lamemakes/pilot-drive-HAT/hardware/3dmodels/RTC_Crystal.step

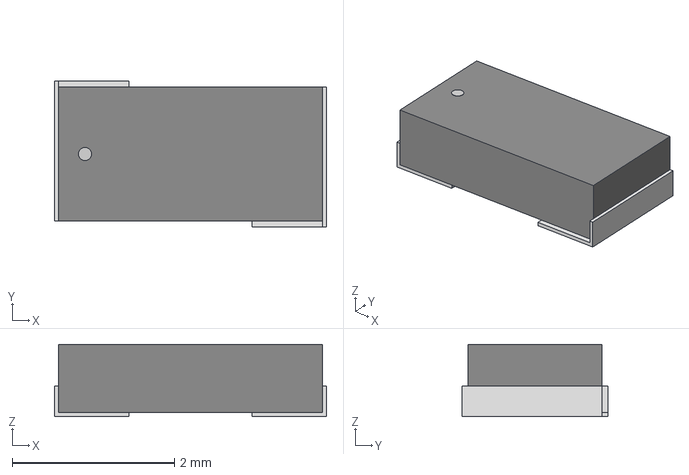
[picture p4: CAD file, 2023-02-22]
hardware/3dmodels/RTC_Crystal.step
3.35 x 1.80 x 0.892 mm
