lamemakes/pilot-drive-HAT/hardware/3dmodels/DS1307Z+T&R.step

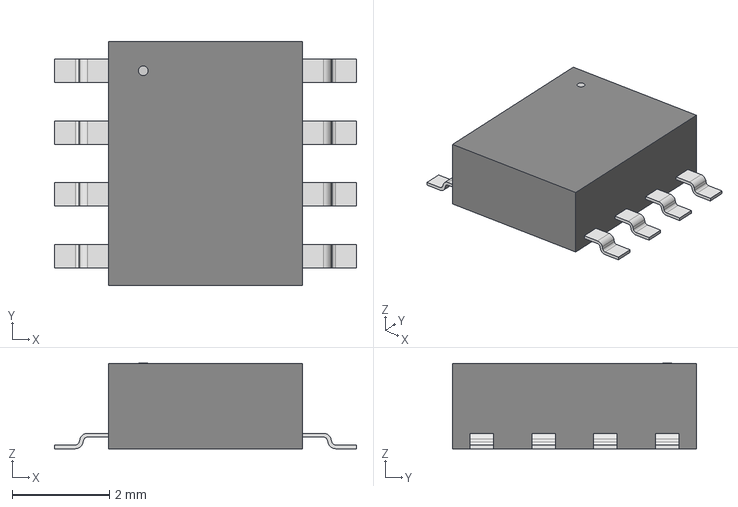
[picture p5: CAD file, 2023-02-22]
hardware/3dmodels/DS1307Z+T&R.step
6.20 x 5.00 x 1.75 mm
