lamemakes/pilot-drive-HAT/hardware/3dmodels/P_FET.step

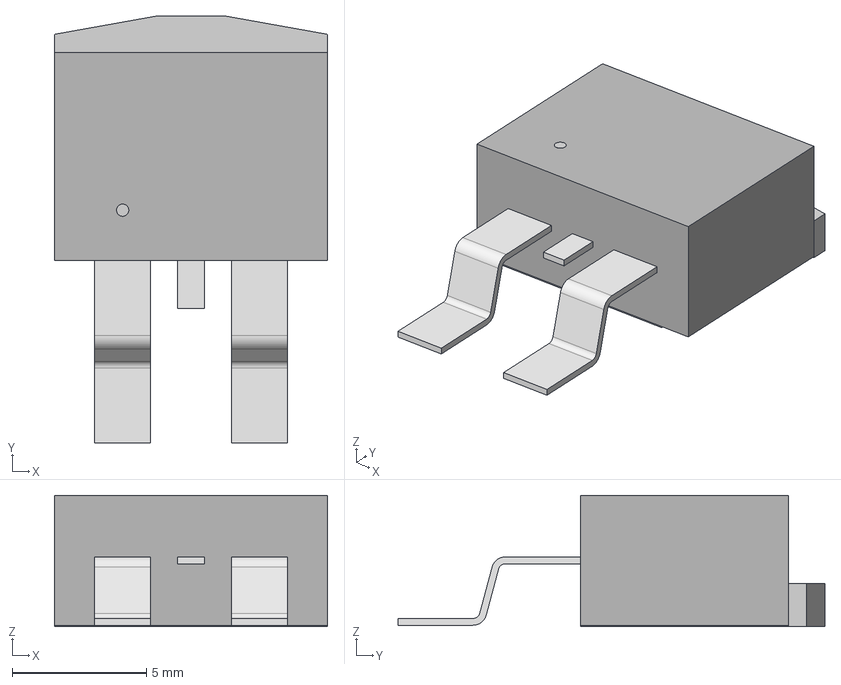
[picture p6: CAD file, 2023-02-22]
hardware/3dmodels/P_FET.step
10.2 x 15.9 x 4.88 mm
