lamemakes/pilot-drive-HAT/hardware/3dmodels/RTC_Battery_Holder.step

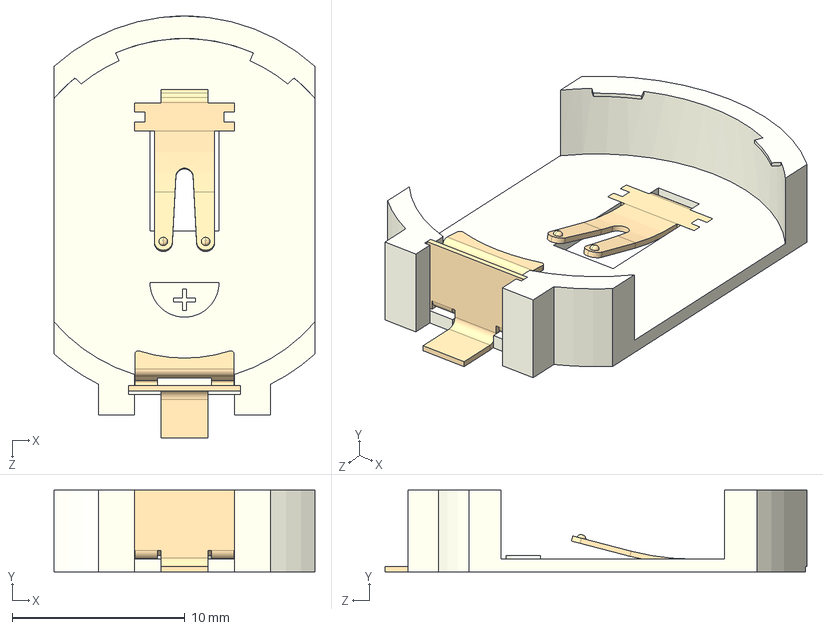
[picture p7: CAD file, 2023-02-22]
hardware/3dmodels/RTC_Battery_Holder.step
15.1 x 4.75 x 24.4 mm
