lamemakes/pilot-drive-HAT/hardware/3dmodels/N_FET.step

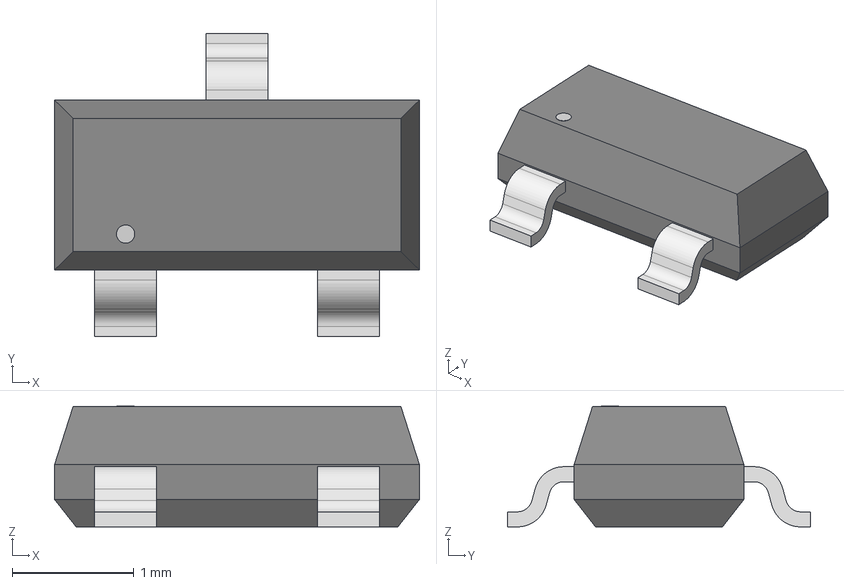
[picture p8: CAD file, 2023-02-22]
hardware/3dmodels/N_FET.step
3.00 x 2.49 x 0.993 mm
