lamemakes/pilot-drive-HAT/hardware/3dmodels/1000uF_10v.step

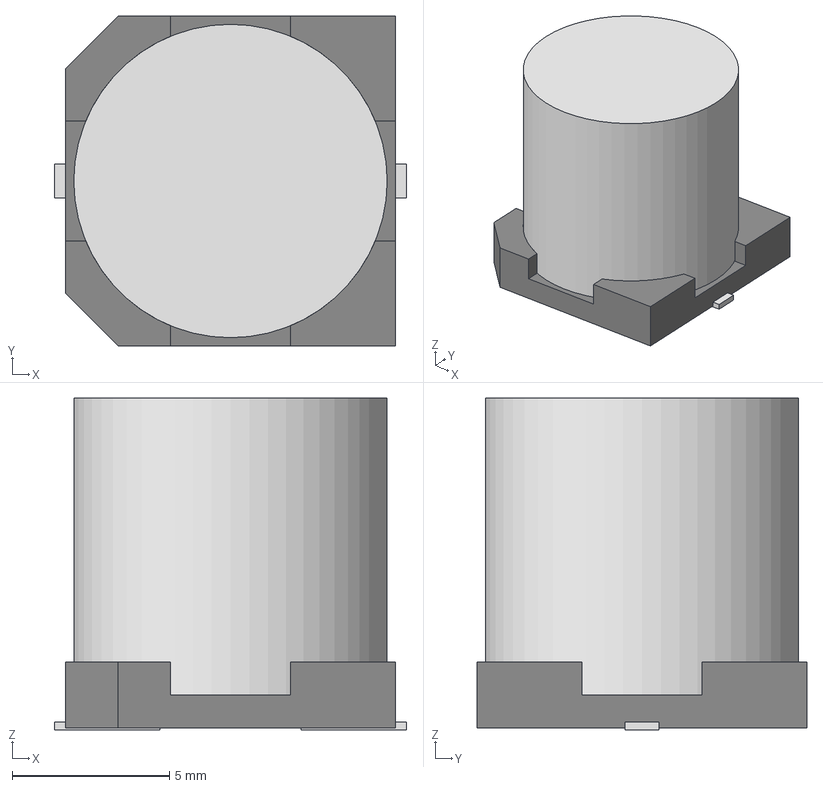
[picture p9: CAD file, 2023-02-22]
hardware/3dmodels/1000uF_10v.step
11.2 x 10.5 x 10.5 mm
