lamemakes/pilot-drive-HAT/hardware/3dmodels/12V_ACC_TVS.step

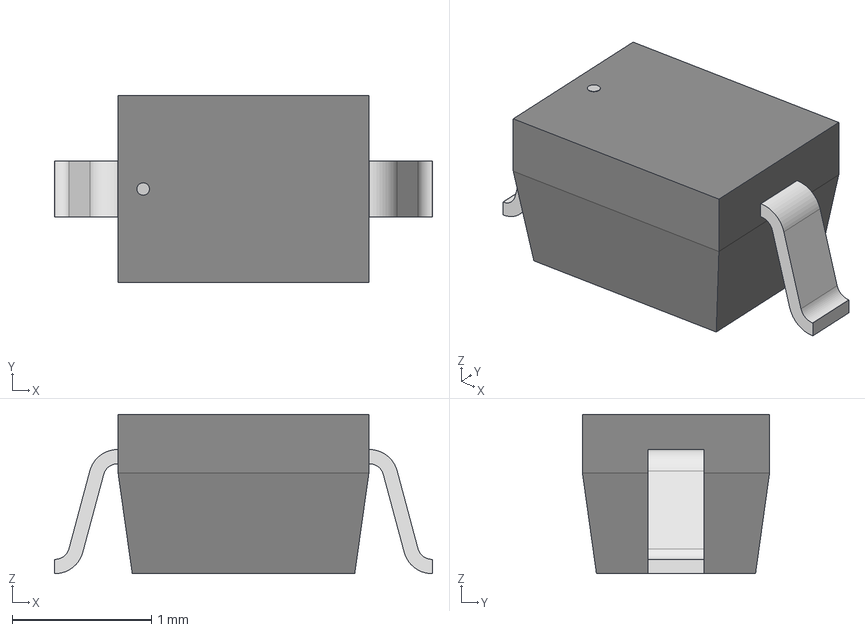
[picture p10: CAD file, 2023-02-22]
hardware/3dmodels/12V_ACC_TVS.step
2.72 x 1.35 x 1.15 mm
