lamemakes/pilot-drive-HAT/hardware/3dmodels/Optocoupler.step

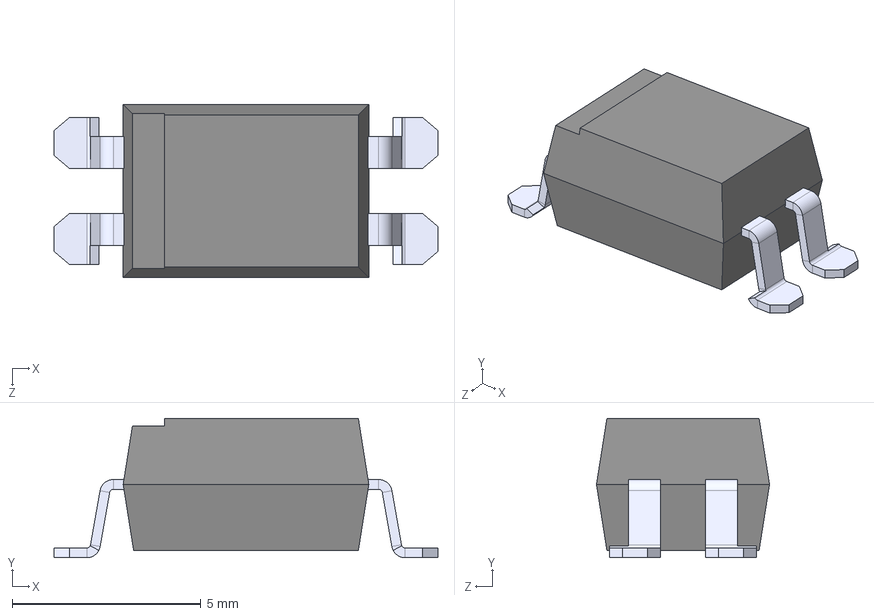
[picture p11: CAD file, 2023-02-22]
hardware/3dmodels/Optocoupler.step
10.2 x 3.69 x 4.58 mm
