lamemakes/pilot-drive-HAT/hardware/3dmodels/100uH_Inductor.step

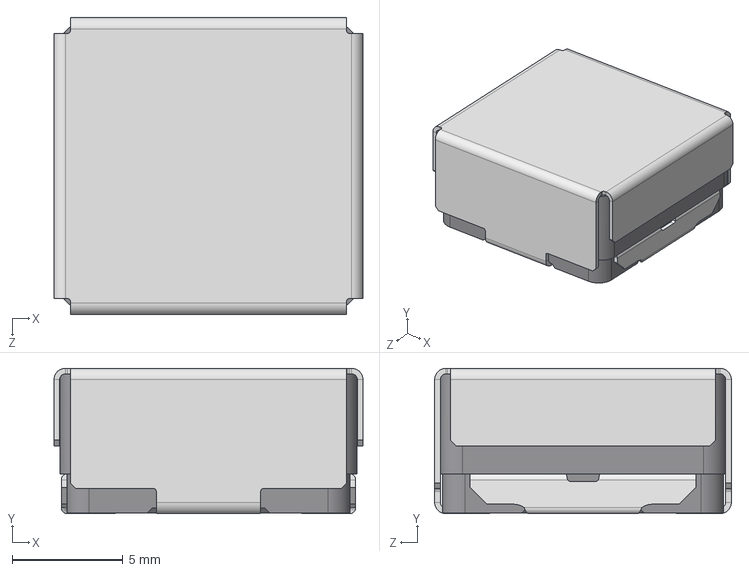
[picture p12: CAD file, 2023-02-22]
hardware/3dmodels/100uH_Inductor.step
13.9 x 6.55 x 13.4 mm
