lamemakes/pilot-drive-HAT/hardware/3dmodels/100uF_35v.step

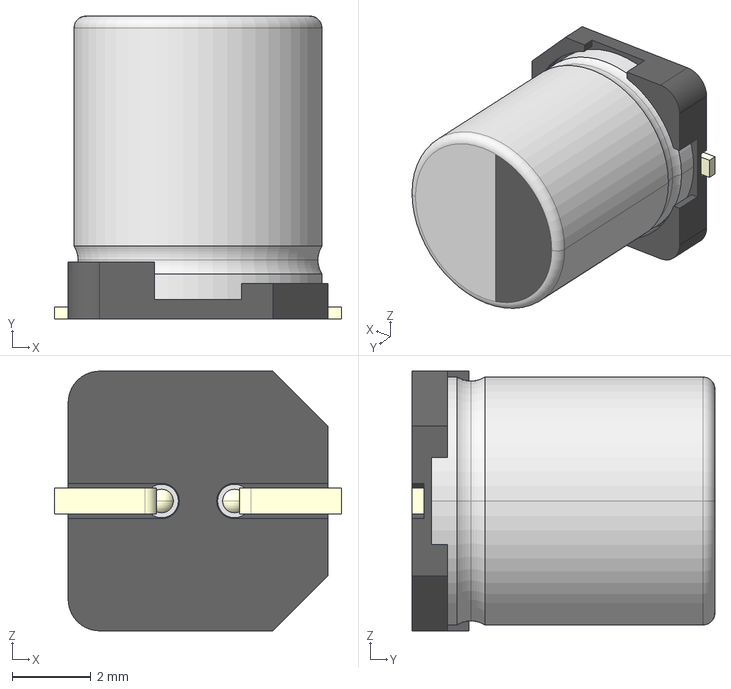
[picture p13: CAD file, 2023-02-22]
hardware/3dmodels/100uF_35v.step
7.30 x 7.70 x 6.60 mm
