lamemakes/pilot-drive-HAT/hardware/3dmodels/ATTINY85_SUR.step

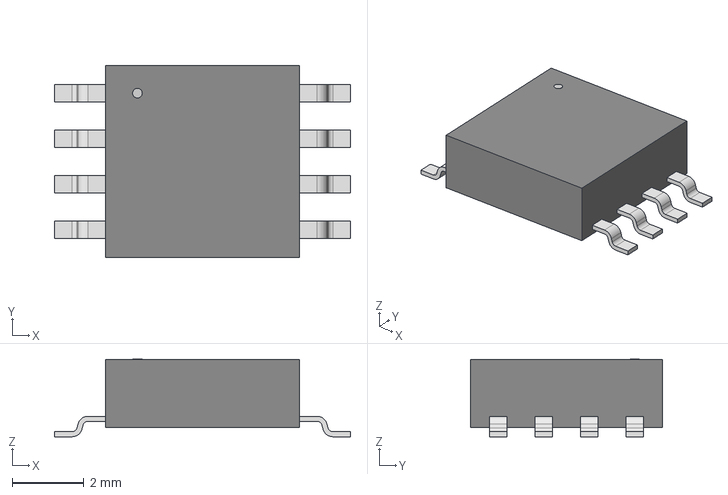
[picture p14: CAD file, 2023-02-22]
hardware/3dmodels/ATTINY85_SUR.step
8.26 x 5.36 x 2.16 mm
