lamemakes/pilot-drive-HAT/hardware/3dmodels/CAT24C128YI-GT3.step

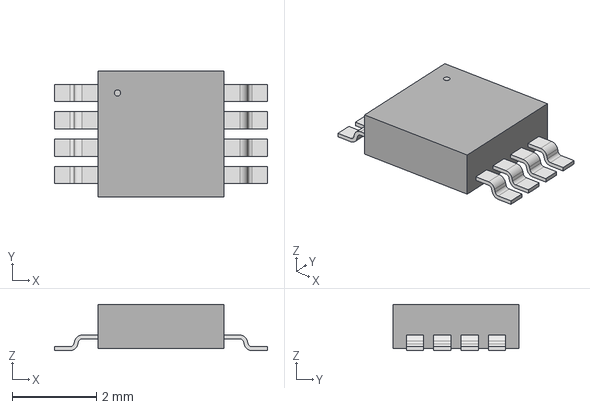
[picture p15: CAD file, 2023-02-22]
hardware/3dmodels/CAT24C128YI-GT3.step
5.05 x 3.00 x 1.09 mm
