lamemakes/pilot-drive-HAT/hardware/3dmodels/3v3_TVS.step

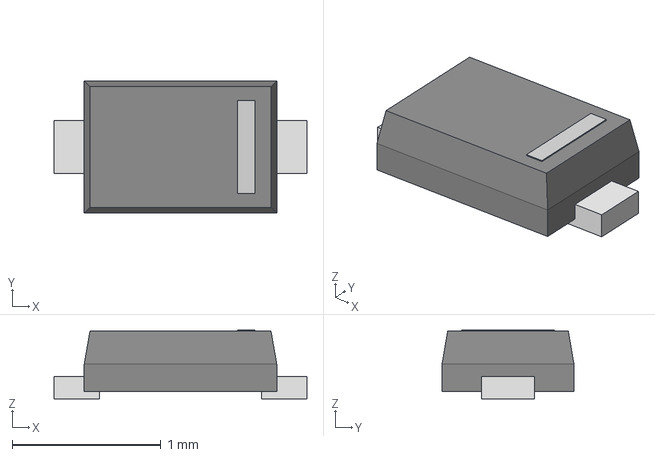
[picture p16: CAD file, 2023-02-22]
hardware/3dmodels/3v3_TVS.step
1.70 x 0.888 x 0.464 mm
