lamemakes/pilot-drive-HAT/hardware/shutdown_circuit.kicad_pcb

## KiCad design hardware/shutdown_circuit.kicad_pcb (2023-07-12)

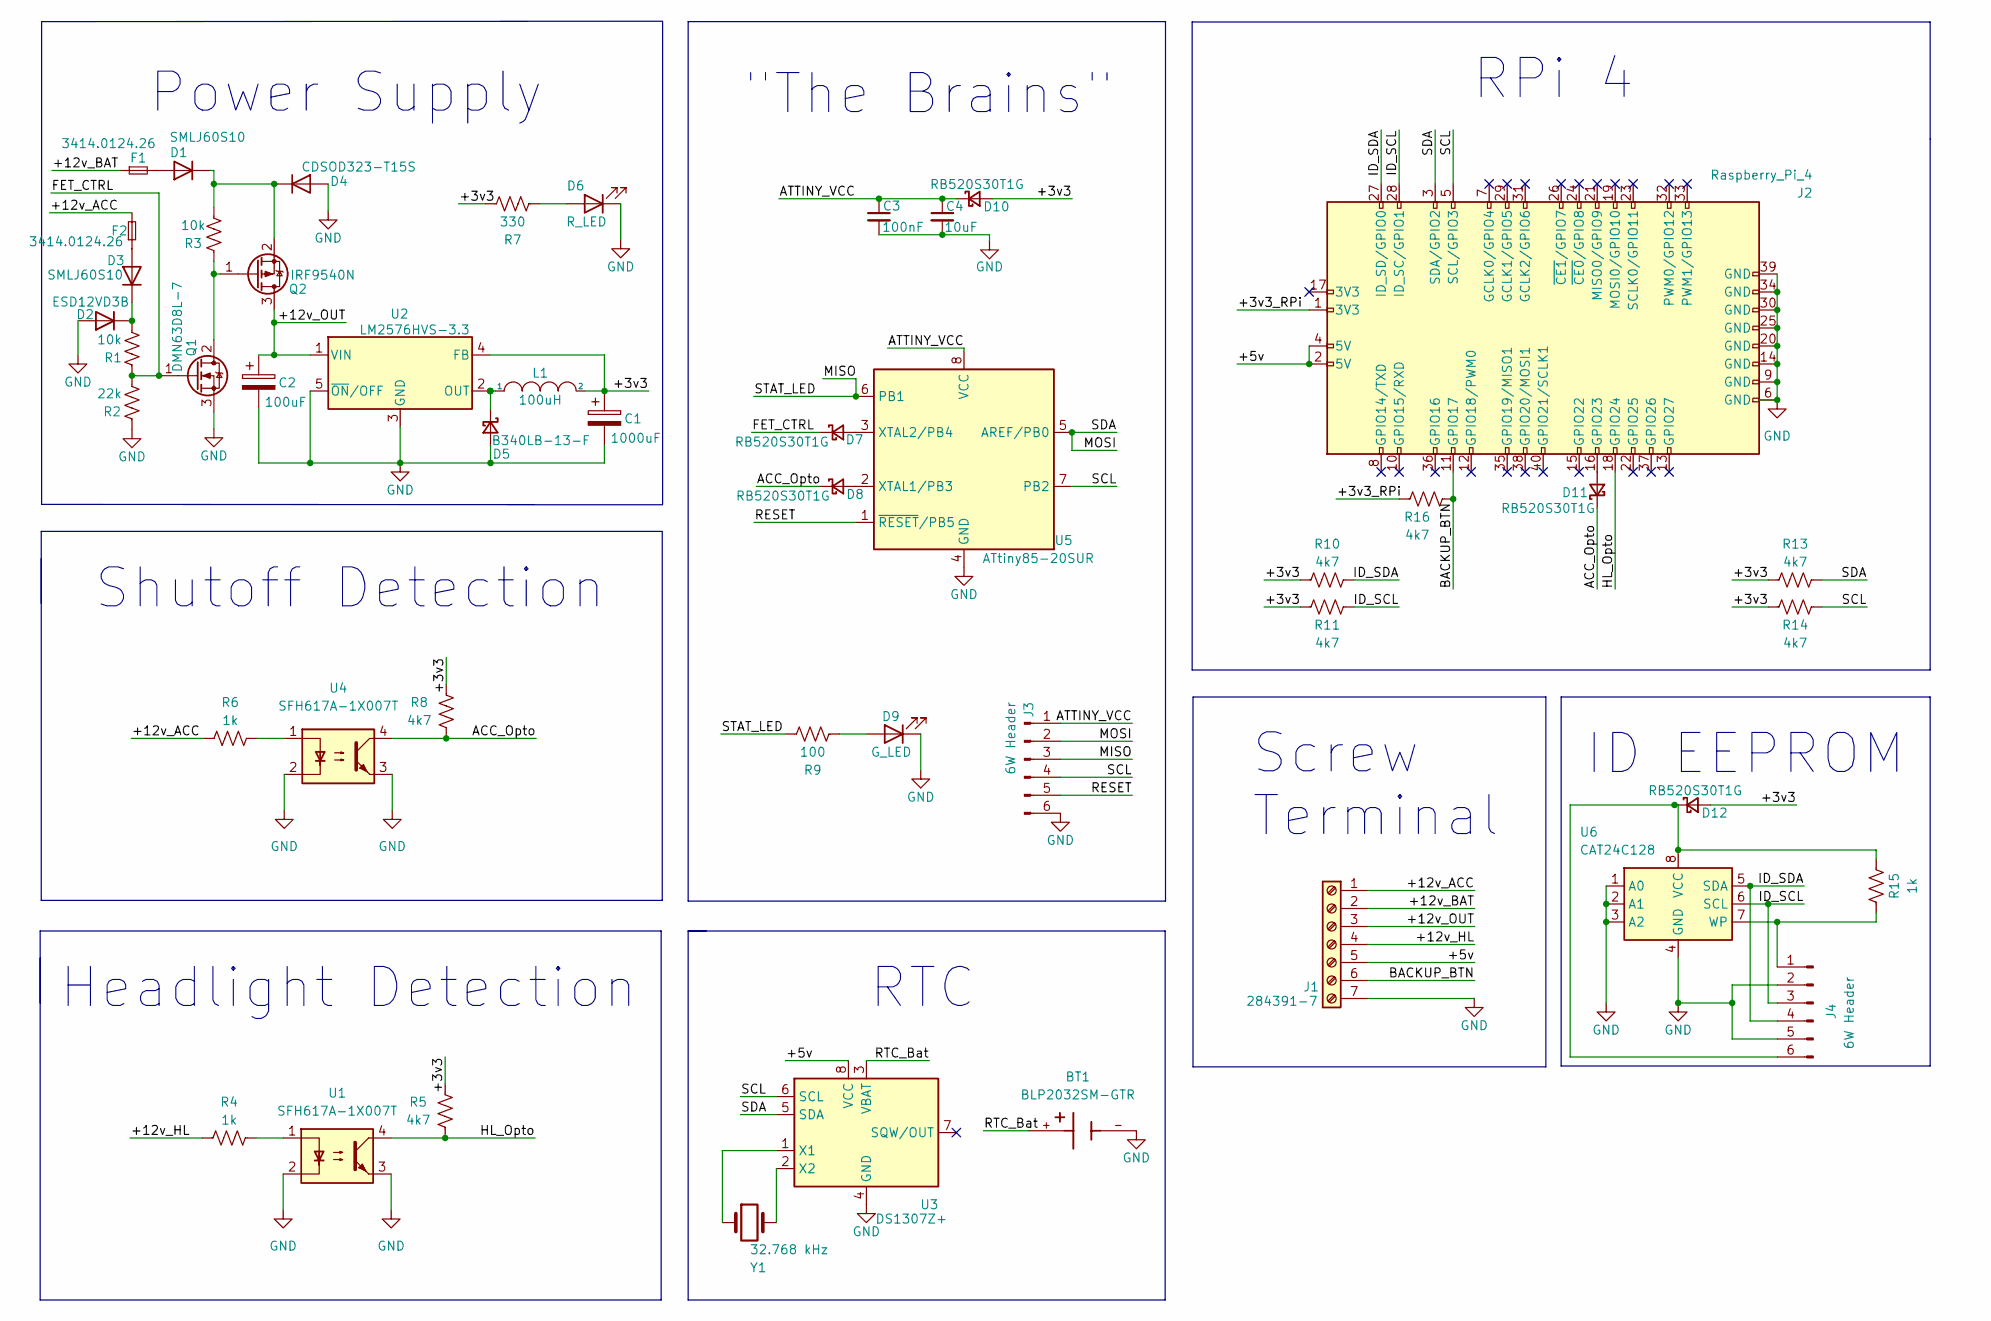
[picture p17: schematic shutdown_circuit.kicad_sch, PILOT Drive Raspberry Pi HAT]

Parts:
BT1: BLP2032SM-GTR; RTC_Battery_Holder; PARTREV J
C1: 1000uF; 1000uF_10v
C2: 100uF; 100uF_35v
C3: 100nF; C_0402_1005Metric_Pad0.74x0.62mm_HandSolder
C4: 10uF; C_0402_1005Metric_Pad0.74x0.62mm_HandSolder
D1, D3: SMLJ60S10; D_SMC_Handsoldering
D2: ESD12VD3B; D_SOD-323
D4: CDSOD323-T15S; D_SOD-323F
D5: B340LB-13-F; D_SMC_Handsoldering
D6: R_LED; LED_0603_1608Metric_Pad1.05x0.95mm_HandSolder
D7, D8, D10, D11, D12: RB520S30T1G; 3v3_TVS
D9: G_LED; LED_0603_1608Metric_Pad1.05x0.95mm_HandSolder
F1, F2: 3414.0124.26; Fuse_0402_1005Metric_Pad0.77x0.64mm_HandSolder
J1: 284391-7; Screw_Term
J2: Raspberry_Pi_4; PinSocket_2x20_P2.54mm_Vertical
J3, J4: 6W Header; PinHeader_1x06_P2.54mm_Vertical
L1: 100uH; 100uH_Inductor
Q1: DMN63D8L-7; N_FET
Q2: IRF9540N; P_FET
R1, R3: 10k; R_0402_1005Metric_Pad0.72x0.64mm_HandSolder
R2: 22k; R_0402_1005Metric_Pad0.72x0.64mm_HandSolder
R4, R6, R15: 1k; R_0402_1005Metric_Pad0.72x0.64mm_HandSolder
R5, R8, R10, R11, R13, R14, R16: 4k7; R_0402_1005Metric_Pad0.72x0.64mm_HandSolder
R7: 330; R_0402_1005Metric_Pad0.72x0.64mm_HandSolder
R9: 100; R_0402_1005Metric_Pad0.72x0.64mm_HandSolder
U1, U4: SFH617A-1X007T; Optocoupler
U2: LM2576HVS-3.3; TO-263-5_TabPin3
U3: DS1307Z+; DS1307Z+T&R
U5: ATtiny85-20SUR; ATTINY_SUR
U6: CAT24C128; CAT24C128YI
Y1: 32.768 kHz; RTC_Crystal

Connections:
/+3v3: C1.1, D10.2 (A), D12.2 (A), L1.2, R5.1, R7.1, R8.1, R10.2, R11.2, R13.2, R14.2, U2.4 (FB)
/+3v3_RPi: J2.1 (3V3), R16.1
/+5v: J1.5, J2.2 (5V), J2.4 (5V), U3.8 (VCC)
/+12v_ACC: F2.2, J1.1, R6.1
/+12v_BAT: F1.1, J1.2
/+12v_HL: J1.4, R4.1
/+12v_OUT: C2.1, J1.3, Q2.3 (D), U2.1 (VIN)
/ACC_Opto: D8.1 (K), D11.1 (K), R8.2, U4.4
/ATTINY_VCC: C3.1, C4.1, D10.1 (K), J3.1, U5.8 (VCC)
/BACKUP_BTN: J1.6, J2.11 (GPIO17), R16.2
/FET_CTRL: D7.1 (K), Q1.1 (G), R1.1, R2.2
/HL_Opto: J2.18 (GPIO24), R5.2, U1.4
/ID_SCL: J2.28 (ID_SC/GPIO1), J4.3, R11.1, U6.6 (SCL)
/ID_SDA: J2.27 (ID_SD/GPIO0), J4.4, R10.1, U6.5 (SDA)
/MISO: J3.3, R9.1, U5.6 (PB1)
/MOSI: J2.3 (SDA/GPIO2), J3.2, R13.1, U3.5 (SDA), U5.5 (AREF/PB0)
/RESET: J3.5, U5.1 (~RESET/PB5)
/RTC_Bat: BT1.+, U3.3 (VBAT)
/SCL: J2.5 (SCL/GPIO3), J3.4, R14.1, U3.6 (SCL), U5.7 (PB2)
GND: BT1.-, C1.2, C2.2, C3.2, C4.2, D2.2 (A), D4.2 (A), D5.2 (A), D6.1 (K), D9.1 (K), J1.7, J2.6 (GND), J2.9 (GND), J2.14 (GND), J2.20 (GND), J2.25 (GND), J2.30 (GND), J2.34 (GND), J2.39 (GND), J3.6, J4.2, J4.5, Q1.3 (S), R2.1, U1.2, U1.3, U2.3 (GND), U2.5 (~ON/OFF), U3.4 (GND), U4.2, U4.3, U5.4 (GND), U6.1 (A0), U6.2 (A1), U6.3 (A2), U6.4 (GND)
unnamed: D1.1 (K), D4.1 (K), Q2.2 (S), R3.2
unnamed: D1.2 (A), F1.2
unnamed: D2.1 (K), D3.1 (K), R1.2
unnamed: D3.2 (A), F2.1
unnamed: D5.1 (K), L1.1, U2.2 (OUT)
unnamed: D6.2 (A), R7.2
unnamed: D7.2 (A), U5.3 (XTAL2/PB4)
unnamed: D8.2 (A), U5.2 (XTAL1/PB3)
unnamed: D9.2 (A), R9.2
unnamed: D11.2 (A), J2.16 (GPIO23)
unnamed: D12.1 (K), J4.6, R15.2, U6.8 (VCC)
unnamed: J4.1, R15.1, U6.7 (WP)
unnamed: Q1.2 (D), Q2.1 (G), R3.1
unnamed: R4.2, U1.1
unnamed: R6.2, U4.1
unnamed: U3.1 (X1), Y1.1
unnamed: U3.2 (X2), Y1.2

Notes on the sheet:
Headlight Detection
RTC
Power Supply
ID EEPROM
Shutoff Detection
Screw Terminal
"The Brains"
RPi 4

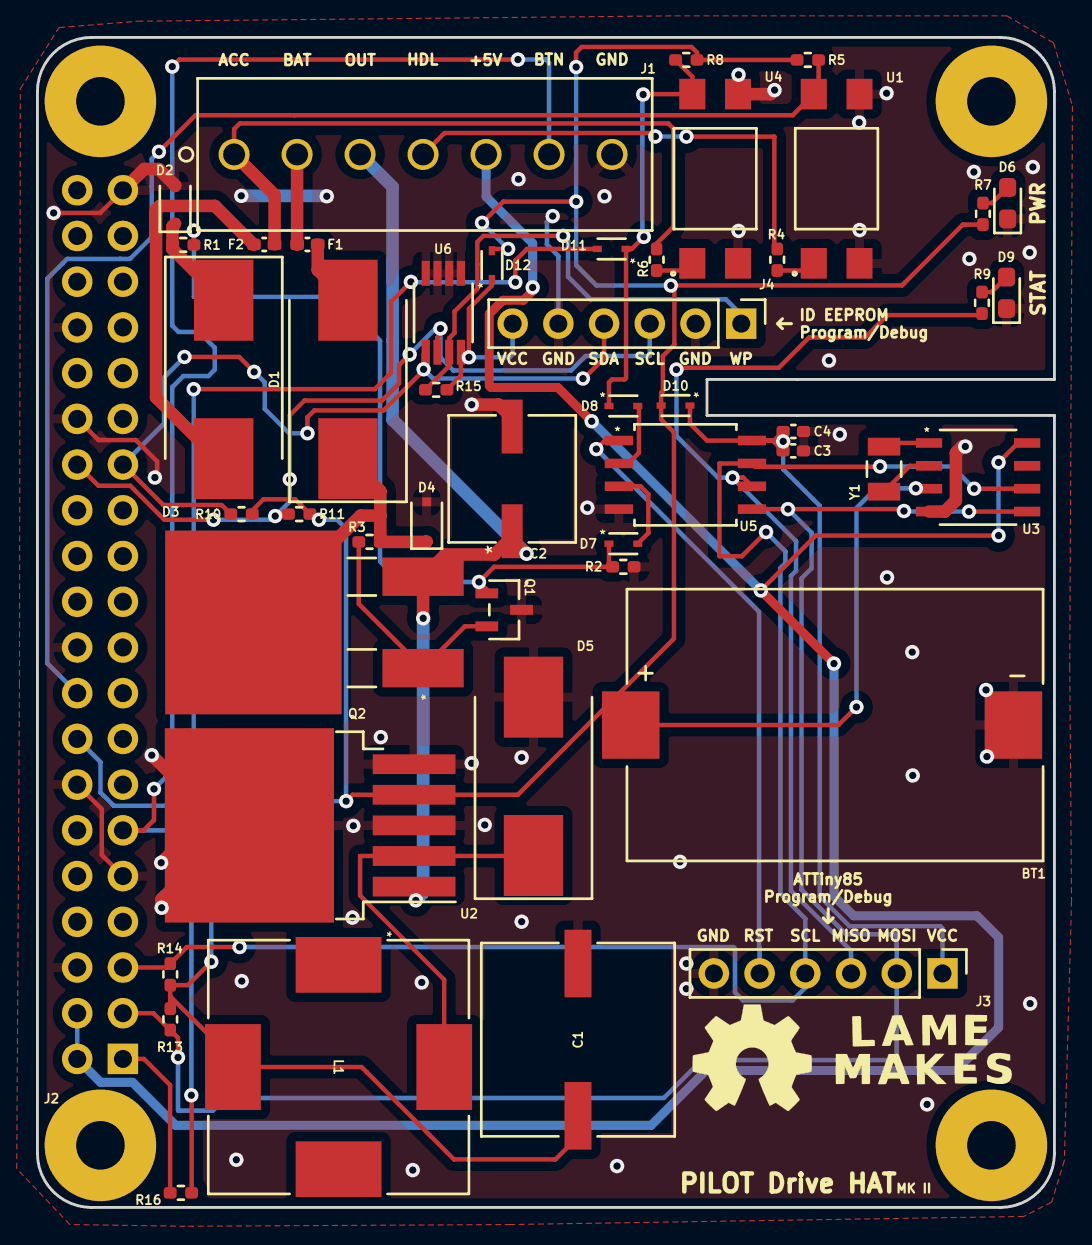
[picture p18: board shutdown_circuit.kicad_pcb from above]

Board: 2 copper layers, 56.5 x 65.0 mm, 48 parts (1 on the bottom side), 37 nets.
