lamemakes/pilot-drive-HAT/(commit log)

2022-09-07 Quick & dirty file upload
    All of these will be extended on moving forward, just wanted something in the books 😎
    [shutdown_circuit.kicad_pcb, shutdown_circuit.kicad_sch]
2022-10-09 Updated KiCad schematic
    ...to include mosfet as a relay replacement & (some) HAT standard implementations such as I2C EEPROM
    [shutdown_circuit.kicad_sch]
2022-10-10 Added I2C functionality
2022-10-14 schematic update
    [shutdown_circuit.kicad_sch]
2022-10-16 Schematic updated to conform to HAT standards + use nets
2022-10-16 Schematic typo fix
2022-10-16 Made schematic conform to HAT standards + added nets
    [shutdown_circuit.kicad_sch]
2022-10-16 More small schematic error fixes
2022-10-26 PCB Updates
2022-10-28 SPI added instead of I2C for ATTINY85 programmer
2022-10-28 Schematic, PCB, and netlist upload
    [shutdown_circuit.kicad_pcb, shutdown_circuit.kicad_sch]
2022-10-28 pilot drive footprints
2023-01-09 Updated for HAT MKII & new firmware
    [shutdown_circuit.kicad_pcb, shutdown_circuit.kicad_sch]
2023-01-10 Fixed some comments along with KiCad schmatic updates
    [HAT_MKII.c, HAT_MKII.h]
2023-01-10 Updated schematic & schematic screenshots
    [shutdown_circuit.kicad_sch]
2023-02-22 PILOT Drive HAT MKII
    [1000uF_10v.step, 100uF_35v.step, 100uH_Inductor.step, 12V_ACC_TVS.step, 3v3_TVS.step, ATTINY85_SUR.step, Battery_Holder.step, CAT24C128YI-GT3.step]
2023-03-04 Post-MKII Prototype fixes
    [shutdown_circuit.kicad_pcb]
2023-03-08 PCB Typo fixes
    [shutdown_circuit.kicad_pcb]
2023-03-17 PCBWay link
2023-07-05 Added better silkscreen text
    [1000uF_10v.step, 100uF_35v.step, 100uH_Inductor.step, 12V_ACC_TVS.step, 3v3_TVS.step, ATTINY85_SUR.step, Battery_Holder.step, CAT24C128YI-GT3.step]
2023-07-12 README RTC updates
    [shutdown_circuit.kicad_pcb]
